freaklabs/BoomBox/hw/sch/Boombox-Mem/Boombox-Mem v0.5.pdf

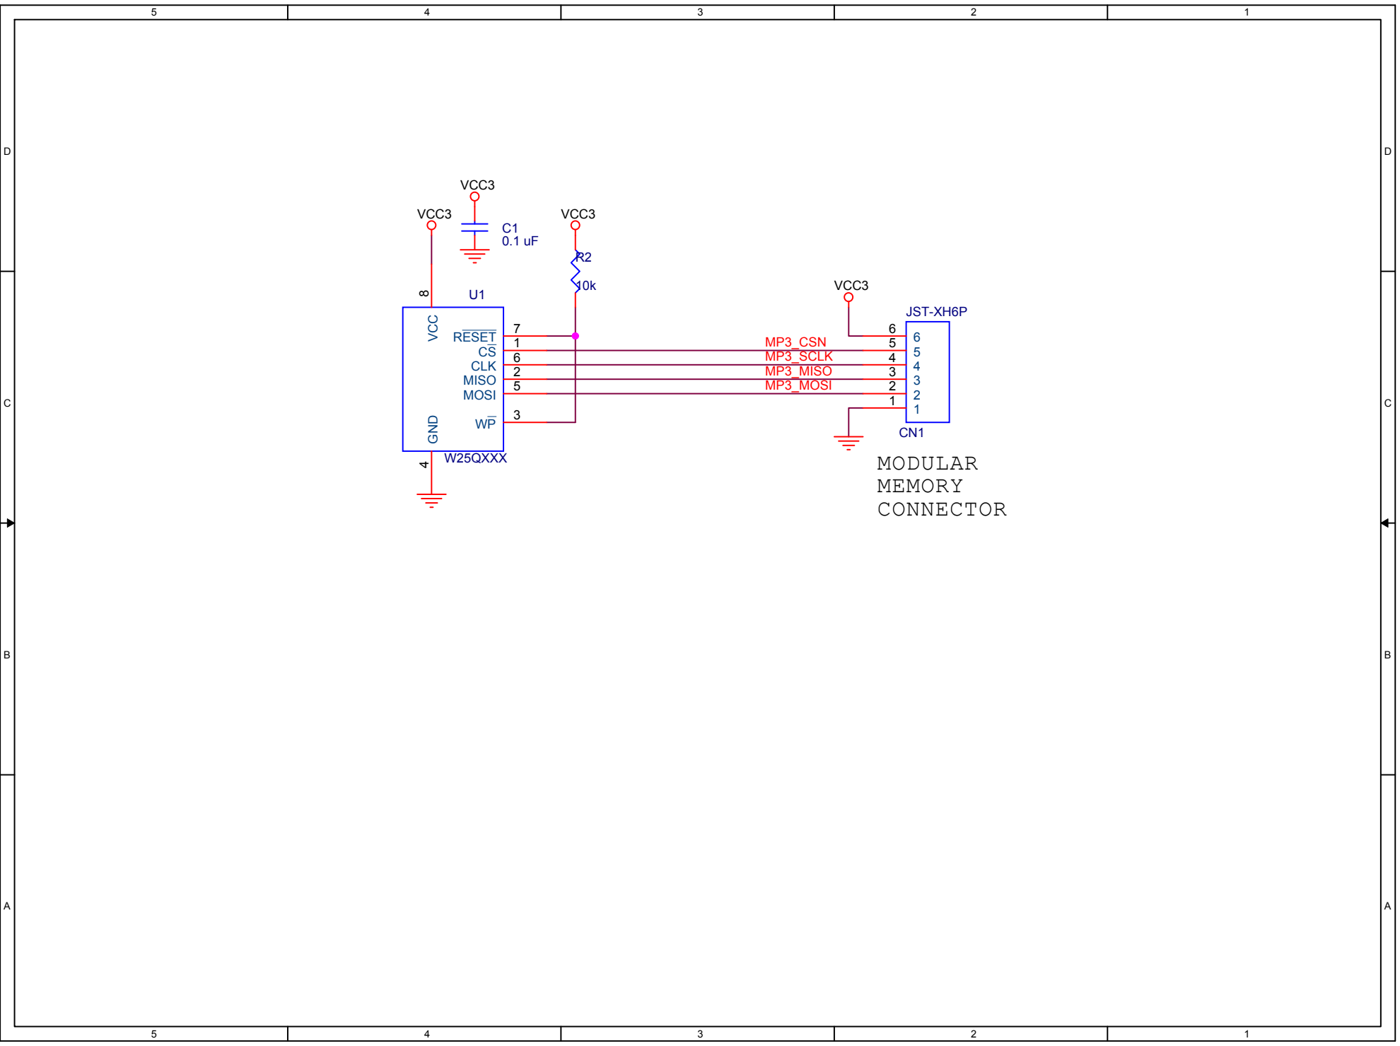
[picture p1: figure]
MODULAR MEMORY CONNECTOR; MP3_CSN MP3_SCLK MP3_MISO MP3_MOSI; VCC3; W25QXXX; MISO; GND; MOSI; CLK; RESET; 7 VCC; JST-XH6P
