freaklabs/BoomBox/hw/sch/Boombox/FL-BOOMBOX.xlsx

Item | Quantity | Reference | Part
1 | 4 | BATT1,CN2,CN3,CN7 | JST-XH2P
2 | 2 | CN1,CN8 | JST-XH6P
3 | 3 | CN4,CN5,CN6 | JST-XH3P
4 | 11 | C1,C4,C9,C10,C13,C14,C15, | 0.1 uF
 |  | C16,C19,C23,C26
5 | 5 | C2,C3,C24,C27,C28 | 100uF/16V
6 | 2 | C5,C6 | 1 uF
7 | 2 | C7,C8 | 0.47 uF
8 | 2 | C11,C12 | 470 uF/6.3V
9 | 2 | C17,C20 | 12pF
10 | 1 | C18 | 22uF/6.3V
11 | 1 | C21 | DNI
12 | 2 | C22,C25 | 22uF, 6.3V
13 | 3 | D1,D2,D3 | RED
14 | 1 | D4 | SCHOTTKY_DIODE
15 | 3 | D5,D6,D7 | DO-35
16 | 4 | H1,H2,H4,H5 | MOUNT_HOLE/MOUNT_HOLE
17 | 1 | H3 | H3X2
18 | 1 | J1 | USB-Mini-AB
19 | 1 | J2 | POWERJACK_STRAIGHT
20 | 2 | L1,L2 | 47 uH
21 | 3 | Q1,Q2,Q3 | APM9926
22 | 1 | R1 | 1k
23 | 13 | R2,R3,R4,R5,R6,R8,R9,R10, | 10k
 |  | R11,R13,R17,R18,R20
24 | 3 | R7,R12,R14 | 220
25 | 2 | R15,R16 | 3k
26 | 1 | R19 | 30k
27 | 1 | SW1 | DIPSWITCH4/DIP
28 | 2 | S1,S3 | PUSHBUTTON/SMD
29 | 1 | S2 | SWITCH_SLIDE/THRU-3
30 | 10 | TP1,TP2,TP3,TP4,TP5,TP6, | TP
 |  | TP7,TP8,TP9,TP10
31 | 1 | U1 | W25QXXX
32 | 1 | U2 | YX6100-16S
33 | 1 | U3 | PAM8403
34 | 1 | U4 | 2.5V
35 | 1 | U5 | ATMEGA328-QFP32
36 | 1 | U6 | AP2112K-3.3TRG1
37 | 1 | U7 | AMS2954C
38 | 1 | U8 | AZ1117
39 | 1 | U9 | CE8301A50
40 | 1 | U10 | XL6009
41 | 1 | VR1 | RV097NS
42 | 1 | Y1 | 7.3728 MHz
