freaklabs/BoomBox/hw/sch/Boombox/fl-boombox-v0.6.pdf

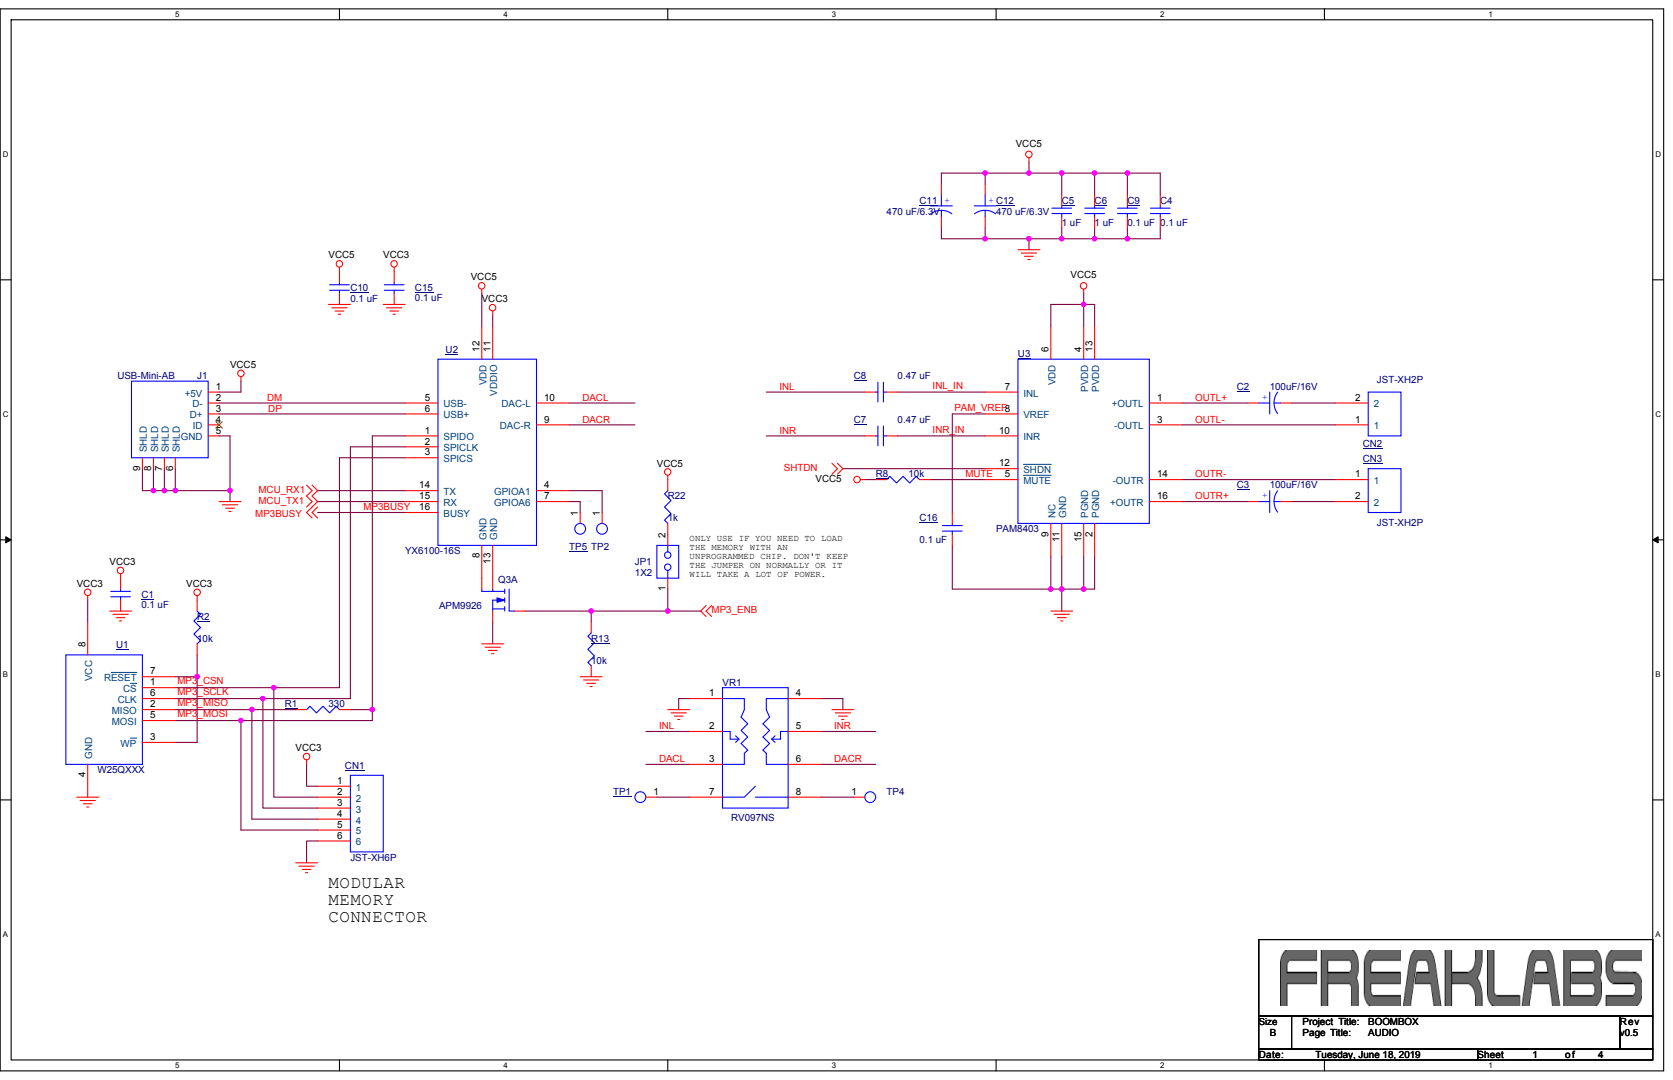
[picture p2: page 1]

SPICS 3

TX 14 RX 15 BUSY 16

ONLY USE IF YOU NEED TO LOAD
THE MEMORY WITH AN
UNPROGRAMMED CHIP. DON'T KEEP
THE JUMPER ON NORMALLY OR IT
WILL TAKE A LOT OF POWER.

Size Size Size B B B | Project Title: Project Title: Project Title: BOOMBOX BOOMBOX BOOMBOX Page Title: Page Title: Page Title: AUDIO AUDIO AUDIO | Rev Rev Rev v0.5 v0.5 v0.5

Date: Tuesday, June 18, 2019 Tuesday, June 18, 2019 Tuesday, June 18, 2019 | Sheet 1 1 1 of 4 4 4

# PIR MOTION SENSOR

## PIR_ENB

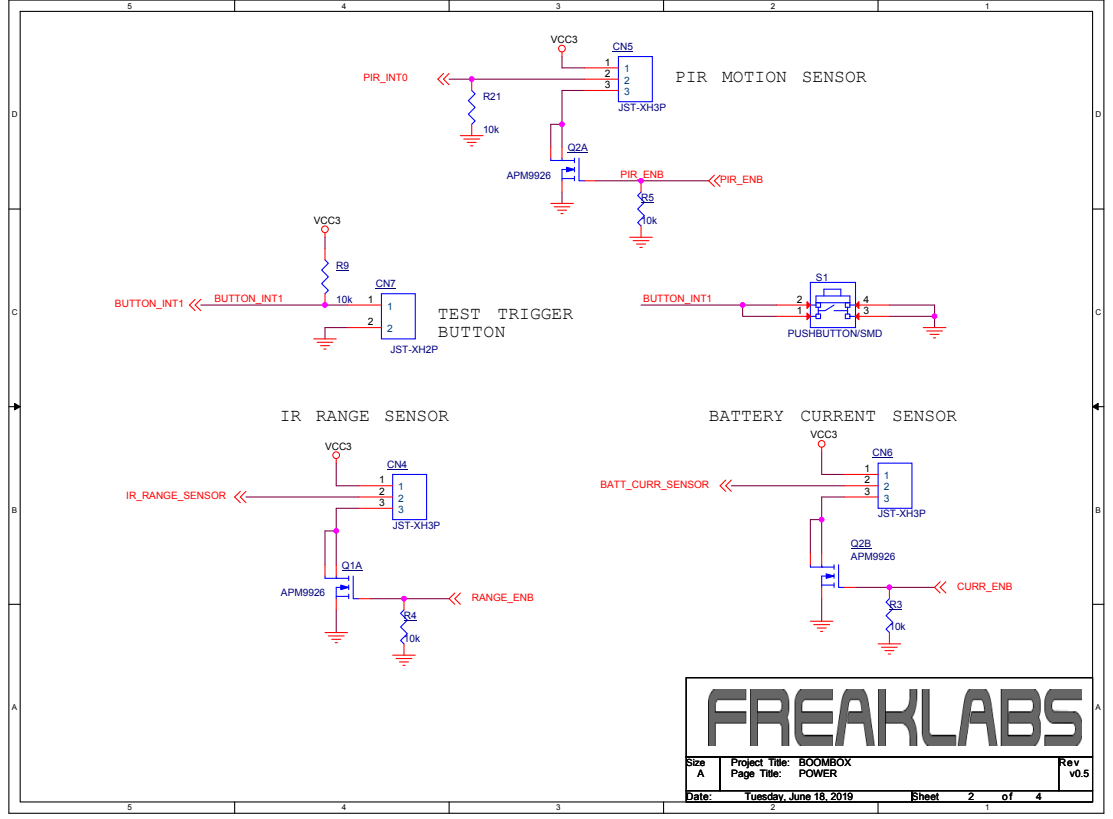
[picture p3: page 2]

Size Size Size A A A | Project Title: Project Title: Project Title: BOOMBOX BOOMBOX BOOMBOX Page Title: Page Title: Page Title: POWER POWER POWER | Rev Rev Rev v0.5 v0.5 v0.5

Tuesday, June 18, 2019 Tuesday, June 18, 2019 Tuesday, June 18, 2019 | 2 2 2 4 4 4

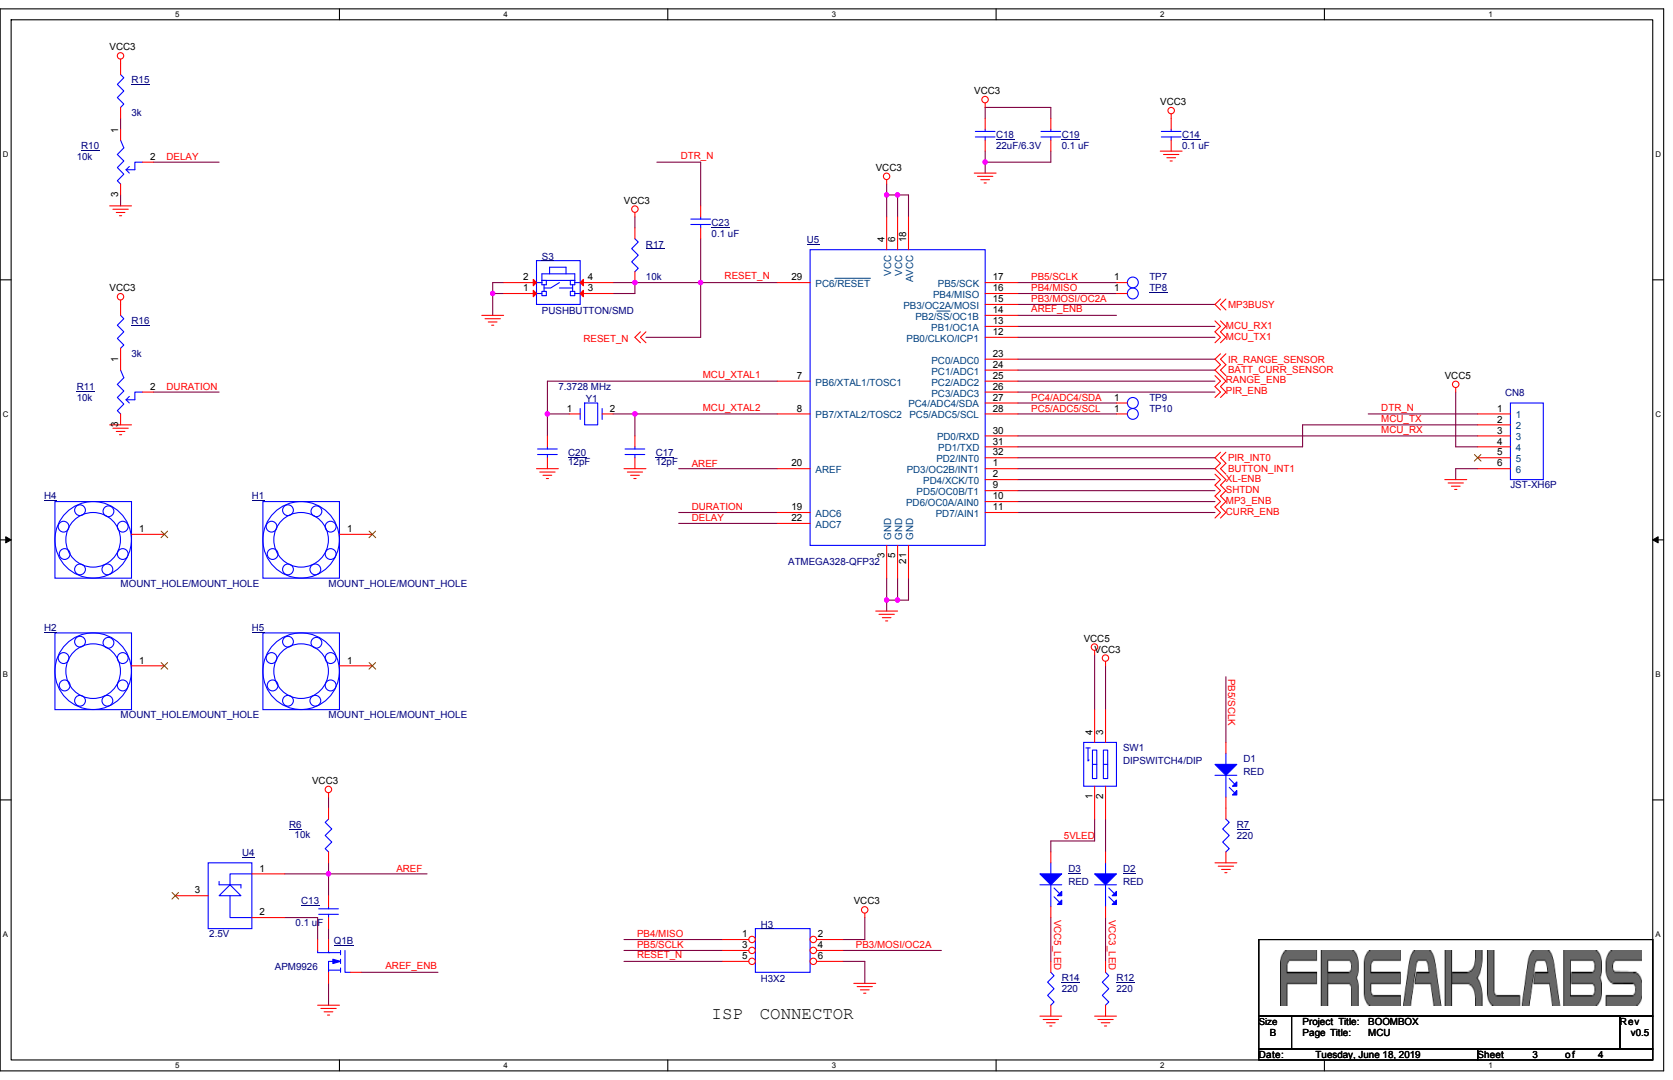
[picture p4: page 3]

MCU_RX | 3 3

Size Size Size B B B | Project Title: Project Title: Project Title: BOOMBOX BOOMBOX BOOMBOX Page Title: Page Title: Page Title: MCU MCU MCU | Rev Rev Rev v0.5 v0.5 v0.5

Tuesday, June 18, 2019 Tuesday, June 18, 2019 Tuesday, June 18, 2019 | 3 3 3 4 4 4

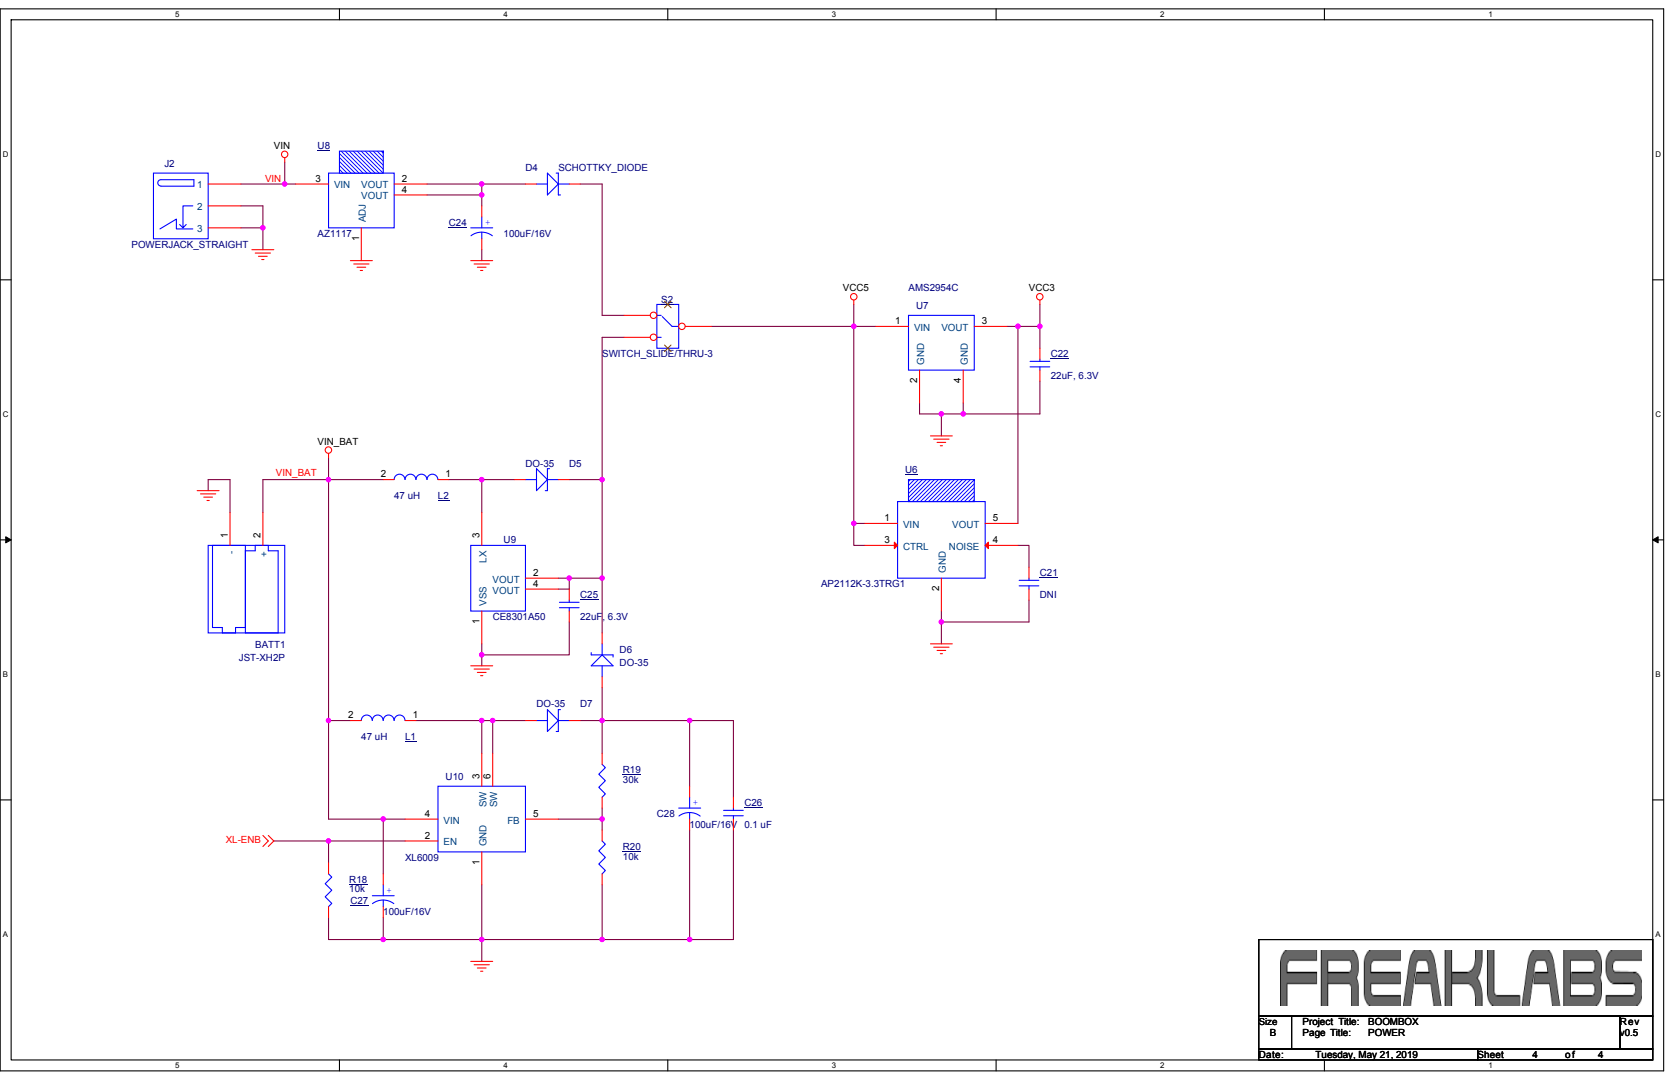
[picture p5: page 4]
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

Tuesday, May 21, 2019 Tuesday, May 21, 2019 Tuesday, May 21, 2019 | 4 4 4
