freaklabs/BoomBox/hw/sch/Boombox/fl-boombox-v0.5.pdf

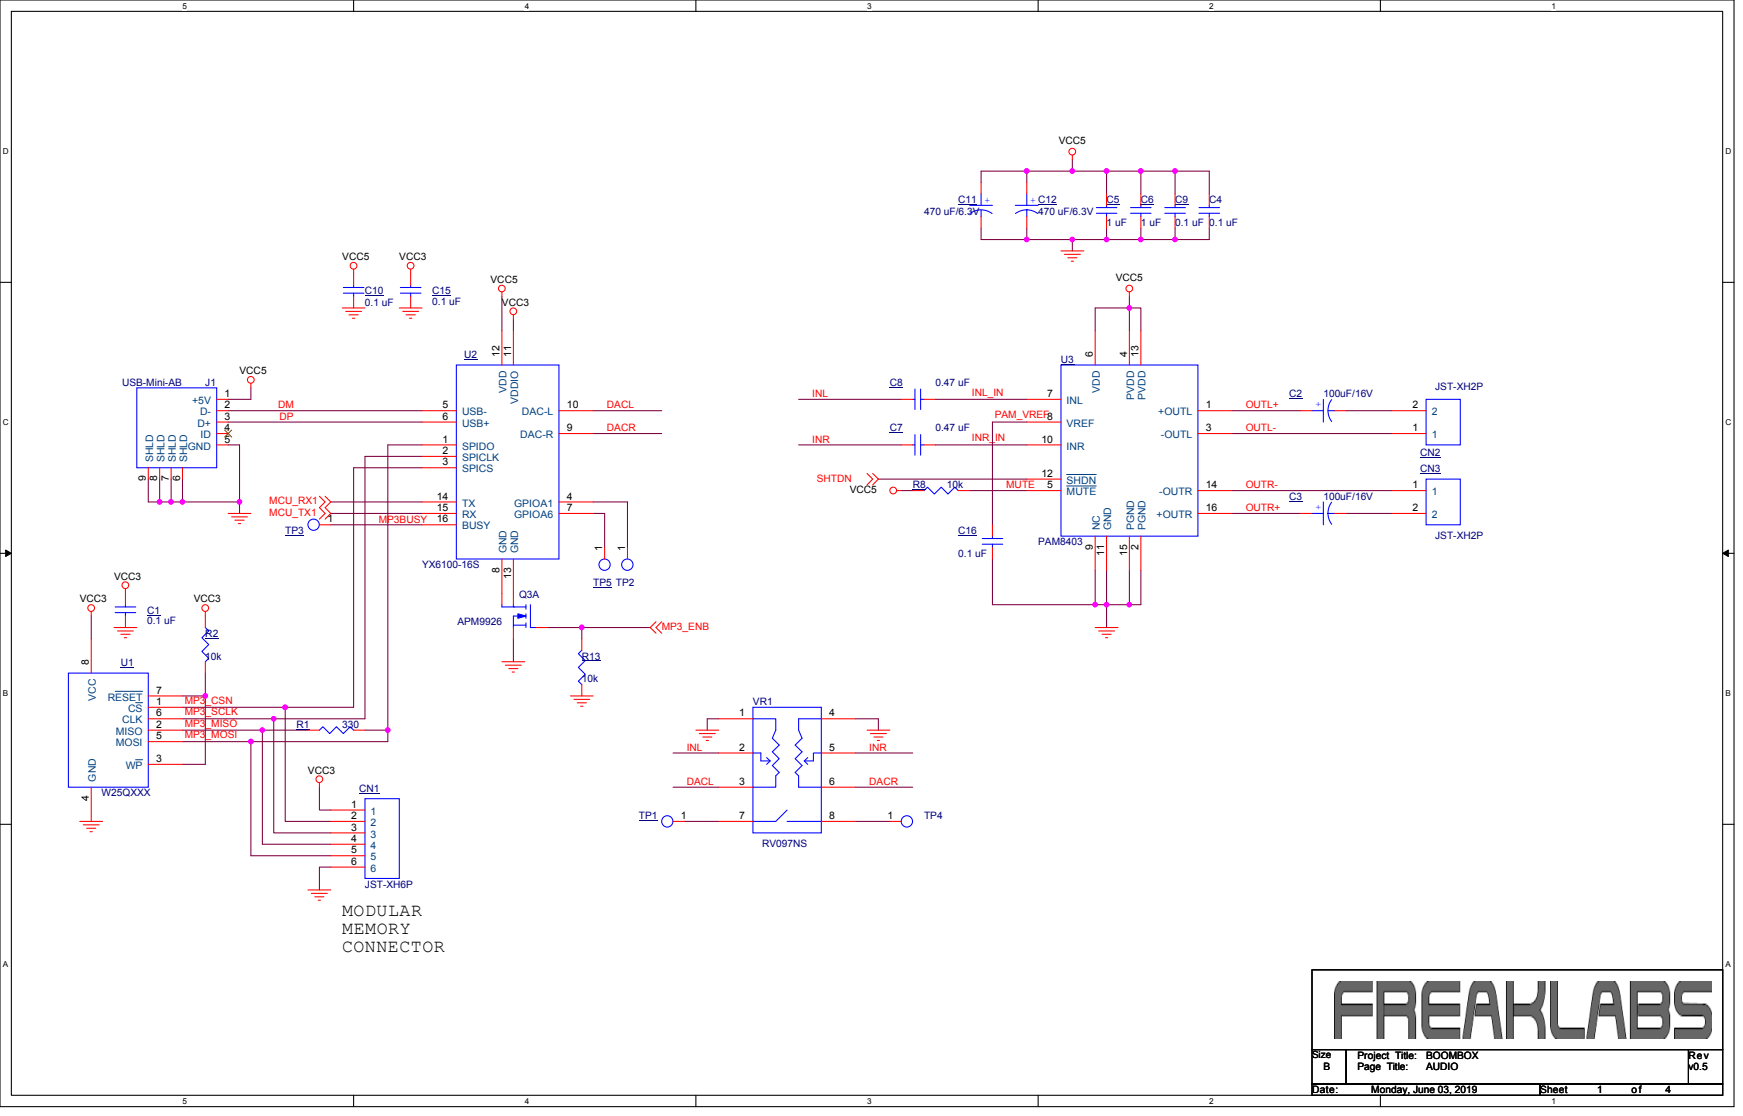
[picture p6: page 1]

SPICS 3

TX 14 RX 15 BUSY 16

Size Size Size B B B | Project Title: Project Title: Project Title: BOOMBOX BOOMBOX BOOMBOX Page Title: Page Title: Page Title: AUDIO AUDIO AUDIO | Rev Rev Rev v0.5 v0.5 v0.5

Date: Date: Date: Monday, June 03, 2019 Monday, June 03, 2019 Monday, June 03, 2019 | Sheet Sheet Sheet 1 1 1 of of of 4 4 4

D | D

# PIR MOTION SENSOR

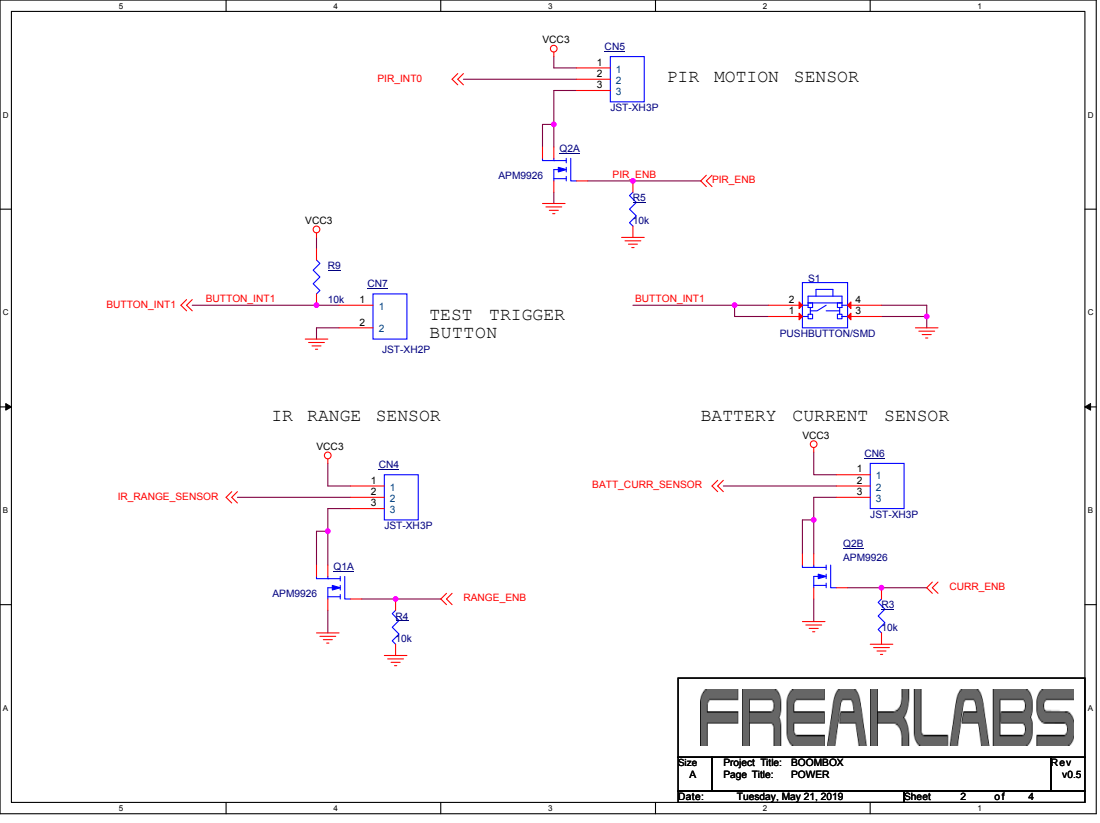
[picture p7: page 2]

Size Size Size A A A | Project Title: Project Title: Project Title: BOOMBOX BOOMBOX BOOMBOX Page Title: Page Title: Page Title: POWER POWER POWER | Rev Rev Rev v0.5 v0.5 v0.5

Date: Date: Date: Tuesday, May 21, 2019 Tuesday, May 21, 2019 Tuesday, May 21, 2019 | Sheet Sheet Sheet 2 2 2 of of of 4 4 4

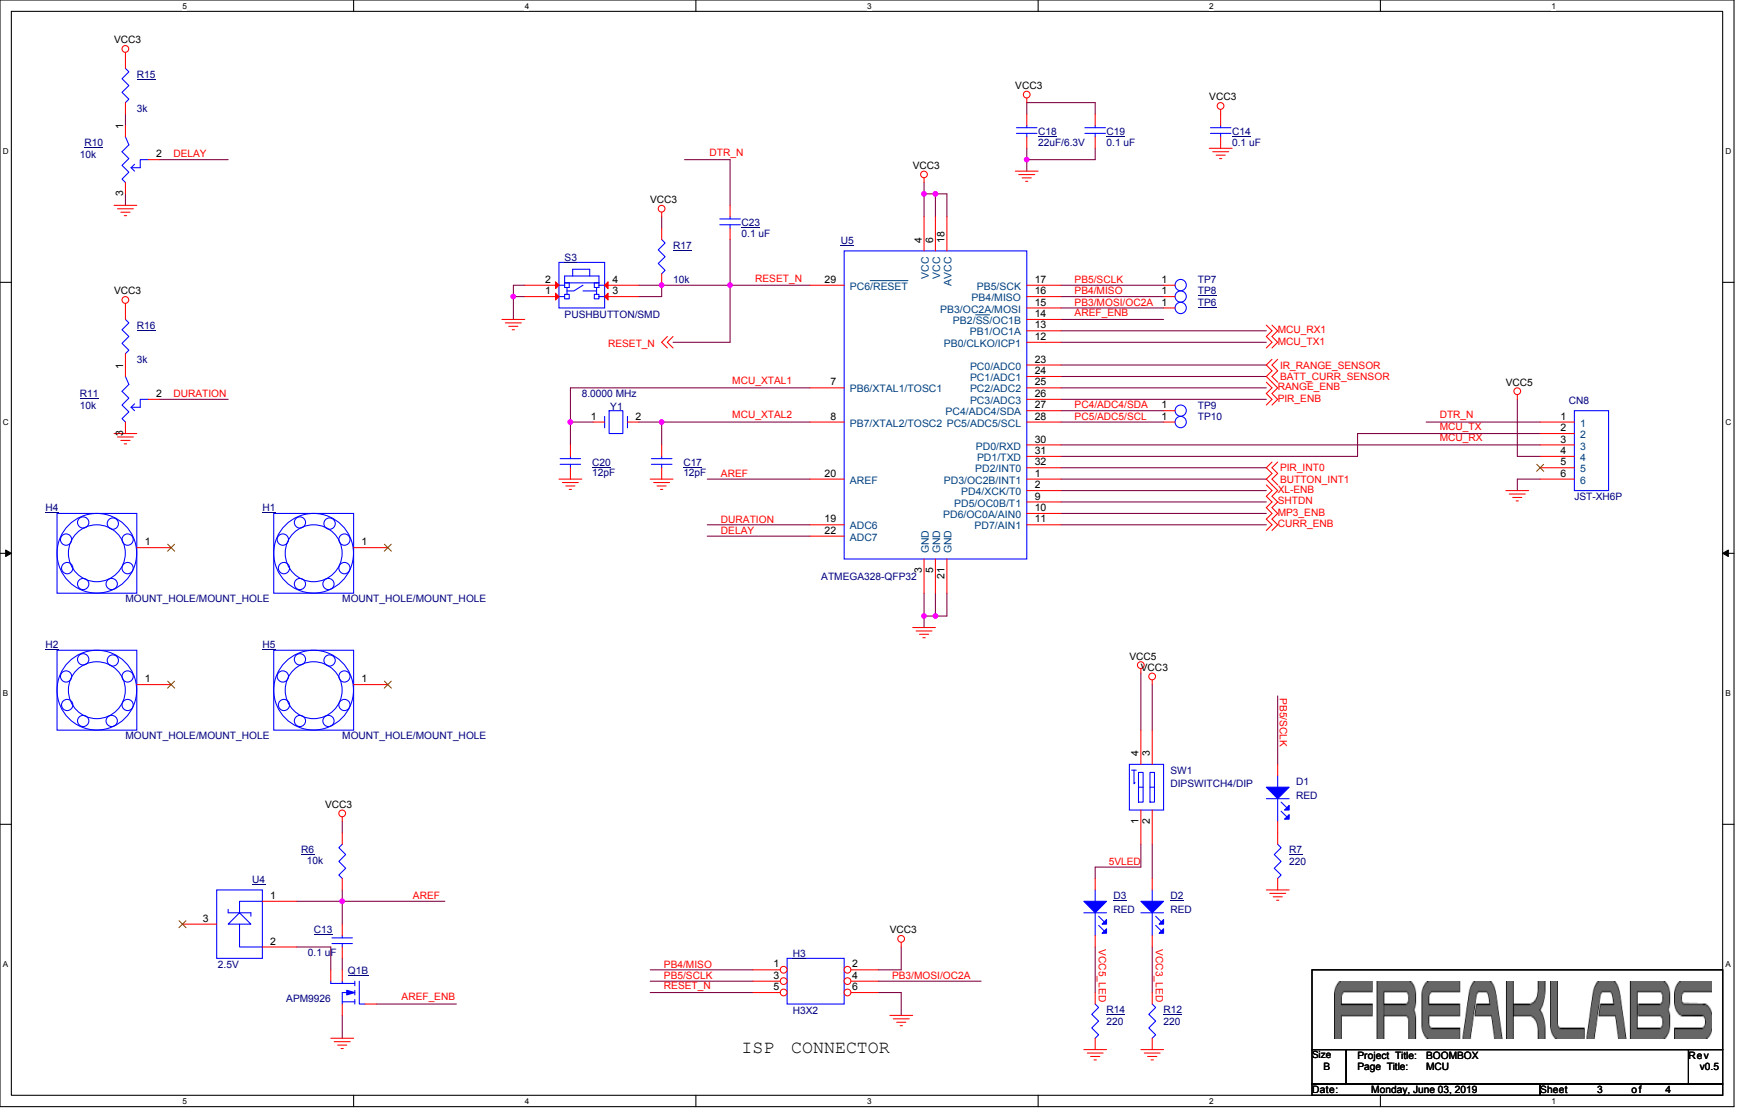
[picture p8: page 3]

Size Size Size B B B | Project Title: Project Title: Project Title: BOOMBOX BOOMBOX BOOMBOX Page Title: Page Title: Page Title: MCU MCU MCU | Rev Rev Rev v0.5 v0.5 v0.5

Date: Date: Date: Monday, June 03, 2019 Monday, June 03, 2019 Monday, June 03, 2019 | Sheet Sheet Sheet 3 3 3 of of of 4 4 4

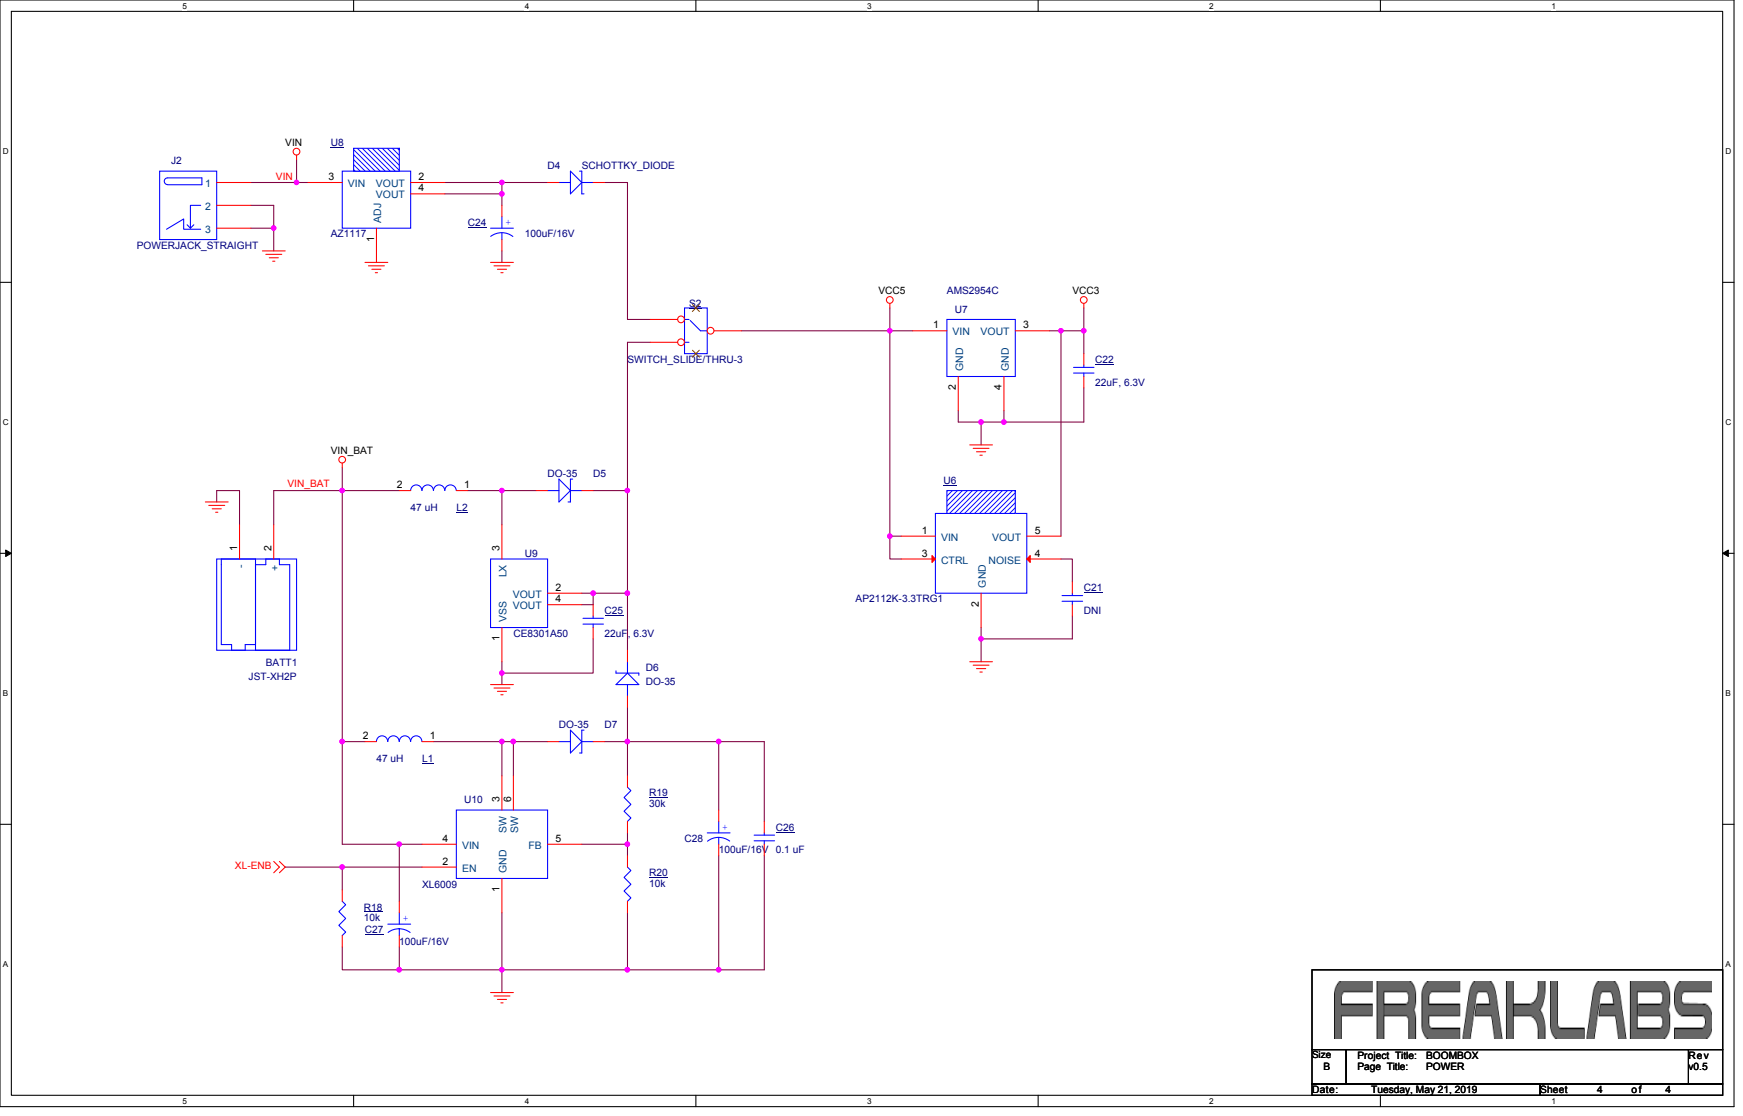
[picture p9: page 4]
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

Date: Date: Date: Tuesday, May 21, 2019 Tuesday, May 21, 2019 Tuesday, May 21, 2019 | Sheet Sheet Sheet 4 4 4 of of of 4 4 4
