freaklabs/BoomBox/(list of files, drawings)

Other design files:
hw/pcb/Boombox-Mem/FL- BOOMBOX-MEM-V0.5.pcb
hw/sch/Boombox-Mem/FL- BOOMBOX-MEM.DSN
hw/sch/Boombox-Mem/FL- BOOMBOX-MEM.opj
hw/sch/Boombox/FL-BOOMBOX.DSN
hw/sch/Boombox/fl-boombox.opj
hw/sch/FL-BOOMBOX.opj
