freaklabs/BoomBox/sw/sketches/boombox/standard/deployment/commands.ino

/**************************************************************************/
// Init command table
/**************************************************************************/
void cmdTableInit()
{
    cmd.add("play", cmdPlay);
    cmd.add("stop", cmdStop);
    cmd.add("settime", cmdSetDateTime);
    cmd.add("gettime", cmdGetDateTime);     
    cmd.add("setname", cmdSetName);
    cmd.add("setid", cmdSetId);
    cmd.add("setmode", cmdSetMode);
    cmd.add("setmaxsounds", cmdSetMaxSounds);
    cmd.add("setshuffle", cmdSetShuffle);
    cmd.add("setdelay", cmdSetDelay);
    cmd.add("setoffdelay", cmdSetOffDelay);
    cmd.add("config", cmdDumpConfig);
    cmd.add("normal", cmdSetNormal);
    cmd.add("help", cmdHelp);
}

/************************************************************/

/************************************************************/
void cmdHelp(int argCnt, char **args)
{
    (void) argCnt;
    (void) args;
        
    Serial.println(F("play          - Play sound. Usage: 'play <sound number>'"));        
    Serial.println(F("stop          - Stop a sound from playing. Usage: 'stop'")); 
    Serial.println(F("vol           - Set volume. Usage: 'vol <num from 1-30>'"));
    Serial.println(F("setname       - Set name. Usage: 'setname <name>'"));
    Serial.println(F("setid         - Set boombox ID. Usage: 'setid <num from 0-255>'"));
    Serial.println(F("setmode       - Set test mode. Usage: 'setmode <0=standalone, 1=camera trap>'"));
    Serial.println(F("setmaxsounds  - Set max number of sounds. Usage: 'setmaxsounds <num>'"));
    Serial.println(F("setshuffle    - Set shuffle mode. Usage: 'setshuffle <0=sequential, 1=shuffle>'"));
    Serial.println(F("setinterval   - Set interval. Currently unused."));
    Serial.println(F("setdelay      - Set delay. This is delay from trigger to playback. Usage: 'setdelay <delay in seconds>'"));
    Serial.println(F("setoffdelay   - Set offdelay. This is blackout period after playback & before next trigger is allowed. Usage: 'setoffdelay <delay in seconds>'"));    
    Serial.println(F("config        - Display metadata configuration data. Usage: 'config'"));
    Serial.println(F("normal        - Go into normal (deployment) mode and exit command line mode. Usage: 'normal'"));
}

/********************************************************************/
// cmdSetNormal
/********************************************************************/
void cmdSetNormal(int argCnt, char **args)
{
    (void) argCnt;
    (void) args;
    
    normalMode = true;   
    Serial.println("Going into normal operation mode.");
    Serial.flush();     
}

/**************************************************************************/
// setDateTime
/**************************************************************************/
void cmdSetDateTime(int argCnt, char **args)
{
#if (BOOMBOX == 1)    
    (void) argCnt;
    (void) args;
        
    uint8_t day, mon, year, hr, min, sec;

    year = strtol(args[1], NULL, 10);
    mon = strtol(args[2], NULL, 10);
    day = strtol(args[3], NULL, 10);
    hr = strtol(args[4], NULL, 10);
    min = strtol(args[5], NULL, 10);
    sec = strtol(args[6], NULL, 10);

    rtc.setDateTime(day, 0, mon, 0, year, hr, min, sec);      
    printf("Now = %s.\n", rtcPrintTimeAndDate());
#endif    
}

/**************************************************************************/
// getDateTime
/**************************************************************************/
void cmdGetDateTime(int argCnt, char **args)
{
#if (BOOMBOX == 1)    
    (void) argCnt;
    (void) args;
        
    printf("Now = %s.\n", rtcPrintTimeAndDate());
#endif    
}

/************************************************************/
//
/************************************************************/
void cmdSetName(int argCnt, char **args)
{
  char buf[MAX_FIELD_SIZE];

  EEPROM.get(EEPROM_META_LOC, meta);
  memset(meta.devName, 0, sizeof(meta.devName));
  strCat(buf, 1, argCnt, args);
  strncpy(meta.devName, buf, MAX_FIELD_SIZE - 1);
  EEPROM.put(EEPROM_META_LOC, meta);
}

/************************************************************/
//
/************************************************************/
void cmdSetDelay(int argCnt, char **args)
{
  if (argCnt != 2)
  {
    Serial.println("Incorrect number of arguments.");
    return;
  }

  uint16_t delayTime = cmd.conv(args[1]);
  EEPROM.get(EEPROM_META_LOC, meta);
  meta.delayTime = delayTime;
  EEPROM.put(EEPROM_META_LOC, meta);
}

/************************************************************/
//
/************************************************************/
void cmdSetOffDelay(int argCnt, char **args)
{
  if (argCnt != 2)
  {
    Serial.println("Incorrect number of arguments.");
    return;
  }

  uint16_t offDelay = cmd.conv(args[1]);
  EEPROM.get(EEPROM_META_LOC, meta);
  meta.offDelayTime = offDelay;
  EEPROM.put(EEPROM_META_LOC, meta);
}
/************************************************************/
//
/************************************************************/
void cmdSetId(int argCnt, char **args)
{
  if (argCnt != 2)
  {
    Serial.println("Incorrect number of arguments.");
    return;
  }

  uint8_t id = cmd.conv(args[1]);
  EEPROM.get(EEPROM_META_LOC, meta);
  meta.devID = id;
  EEPROM.put(EEPROM_META_LOC, meta);
}

/************************************************************/
//
/************************************************************/
void cmdSetMode(int argCnt, char **args)
{
  if (argCnt != 2)
  {
    Serial.println("Incorrect number of arguments.");
    return;
  }

  uint8_t mode = cmd.conv(args[1]);

  if (mode > 1)
  {
    printf("ERROR: Invalid value. Setting to 0.\n");
    printf("Usage: 0 = STANDALONE mode, 1 = TRAILCAM mode\n");
  }
  
  EEPROM.get(EEPROM_META_LOC, meta);
  meta.devMode = mode;
  EEPROM.put(EEPROM_META_LOC, meta);
}

/************************************************************/
//
/************************************************************/
void cmdSetMaxSounds(int argCnt, char **args)
{
  if (argCnt != 2)
  {
    Serial.println("Incorrect number of arguments.");
    return;
  }

  uint16_t maxSounds = cmd.conv(args[1]);
  EEPROM.get(EEPROM_META_LOC, meta);
  meta.maxSounds = maxSounds;
  EEPROM.put(EEPROM_META_LOC, meta);
  boombox.setMaxSounds(meta.maxSounds);
}

/************************************************************/
//
/************************************************************/
void cmdSetShuffle(int argCnt, char **args)
{
  if (argCnt != 2)
  {
    Serial.println("Incorrect number of arguments.");
    return;
  }

  bool shuffleEnb = cmd.conv(args[1]);
  EEPROM.get(EEPROM_META_LOC, meta);
  meta.shuffleEnable = shuffleEnb;
  EEPROM.put(EEPROM_META_LOC, meta);

  if (meta.shuffleEnable == 0)
  {
    boombox.setShuffle(0);
  }
  else
  {
    boombox.setShuffle(1);
  }
  boombox.initPlaylist(playlist, meta.maxSounds, meta.shuffleEnable);
}

/**************************************************************************/
// cmdSetSite
/**************************************************************************/
void cmdDumpConfig(int argCnt, char **args)
{
    (void) argCnt;
    (void) args;

    Serial.print(F("Device Name: \t")); Serial.println(meta.devName); 
    Serial.print(F("Device ID:   \t")); Serial.println(meta.devID);
    Serial.print(F("Shuffle:     \t")); Serial.println(meta.shuffleEnable); 
    Serial.print(F("Device Mode: \t")); Serial.println(meta.devMode ? "TRAILCAM" : "STANDALONE");
    Serial.print(F("Max Sounds:  \t")); Serial.println(meta.maxSounds);
    Serial.print(F("Delay Time:  \t")); Serial.println(meta.delayTime);
    Serial.print(F("Off Delay:   \t")); Serial.println(meta.offDelayTime);
    Serial.print(F("Interval:    \t")); Serial.println(meta.devInterval);
}

/************************************************************/
// Play track
// Usage: play <track number>
/************************************************************/
void cmdPlay(int argCnt, char **args)
{
    (void) argCnt;   
   
    uint8_t track = cmd.conv(args[1]);

    // enable amp
    boombox.ampEnable();       
    delay(AMP_ENABLE_DELAY); // this delay is short and just so the start of the sound doesn't get cut off as amp warms up
    digitalWrite(boombox.pinMute, HIGH); // unmute system
    
    boombox.playBusy(track);

    // disable amp before going to sleep. Short delay so sound won't get cut off too suddenly
    // with additional delay after to allow amp to shut down
    delay(500);
    digitalWrite(boombox.pinMute, LOW); // mute system  
    boombox.ampDisable();   
}

/************************************************************/
// Set volume
// Usage: vol <volume level>
// volume level is between 0 and 30
/************************************************************/
void cmdSetVolume(int argCnt, char **args)
{
    (void) argCnt;
    
    uint8_t vol = cmd.conv(args[1]);
    if (vol > 30)
    {
        vol = 30;
    }
    boombox.setVol(vol);
}

/************************************************************/
// Stop playing
/************************************************************/
void cmdStop(int argCnt, char **args)
{
    (void) argCnt;
    (void) args;
        
    boombox.stop();
}
