freaklabs/BoomBox/sw/sketches/boombox/disco/testOnly-disco/helpers.ino

/**************************************************************************/
// Fill strip pixels one after another with a color. Strip is NOT cleared
// first; anything there will be covered pixel by pixel. Pass in color
// (as a single 'packed' 32-bit value, which you can get by calling
// strip.Color(red, green, blue) as shown in the loop() function above),
// and a delay time (in milliseconds) between pixels.
/**************************************************************************/
void colorWipe0(uint32_t color, int wait) {
  for(uint16_t i=0; i<strip0.numPixels(); i++) { // For each pixel in strip...
    strip0.setPixelColor(i, color);         //  Set pixel's color (in RAM)
    strip0.show();                          //  Update strip to match
    delay(wait);                           //  Pause for a moment
  }
}

/**************************************************************************/
// Fill strip pixels one after another with a color. Strip is NOT cleared
// first; anything there will be covered pixel by pixel. Pass in color
// (as a single 'packed' 32-bit value, which you can get by calling
// strip.Color(red, green, blue) as shown in the loop() function above),
// and a delay time (in milliseconds) between pixels.
/**************************************************************************/
void colorWipe1(uint32_t color, int wait) {
  for(uint16_t i=0; i<strip1.numPixels(); i++) { // For each pixel in strip...
    strip1.setPixelColor(i, color);         //  Set pixel's color (in RAM)
    strip1.show();                          //  Update strip to match
    delay(wait);                           //  Pause for a moment
  }
}

/**************************************************************************/
/*!
    Concatenate multiple strings from the command line starting from the
    given index into one long string separated by spaces.
*/
/**************************************************************************/
int strCat(char *buf, unsigned char index, char argCnt, char **args)
{
    uint8_t i, len;
    char *data_ptr;

    data_ptr = buf;
    for (i=0; i<argCnt - index; i++)
    {
        len = strlen(args[i+index]);
        strcpy((char *)data_ptr, (char *)args[i+index]);
        data_ptr += len;
        *data_ptr++ = ' ';
    }
    // remove the trailing space
    data_ptr--;
    *data_ptr++ = '\0';

    return data_ptr - buf;
}

/**************************************************************************/
// This is to implement the printf function from within arduino
/**************************************************************************/
int uart_putchar (char c, FILE *stream)
{
    (void) stream;
    Serial.write(c);
    return 0;
}
