freaklabs/BoomBox/(commit log)

2019-07-22 - Added Boombox schematic and PCB v0.6 - Added examples for boombox - Modified boombox library files
    [FL- BOOMBOX-MEM-V0.5.pcb, FL- BOOMBOX-MEM.DSN, FL- BOOMBOX-MEM.opj, FL-BOOMBOX.DSN, FL-BOOMBOX.xlsx, fl-boombox.opj]
2019-07-31 - Added sleep mode - Added watchdog timer funcitonality - Fixed bug in sketch to disable watchdog timer before going to sleep - added delay in wake
2019-08-01 - Modified sketch to have delay to fully play out mp3 sample
2019-08-04 Fixed button debounce issue on hardware Uploaded working boomboxMain file
2019-08-08 Added PIR deployment code Modified sleep code to keep PIR powered on during sleep
2021-07-10 Made modifications based on current setup
2021-07-10 Added drivers for USB serial
2021-07-20 Adding Low Power library Changed name to deploymentBoomboxMain Removed PIR sketch
2021-07-21 Added workaround for floating shutdown issue Implemented randomized shuffle playlist function in sketches
    [deploymentBoomboxMain.ino, testBoomboxTrailcam.ino]
2022-03-10 Removed hardware directory. Please update board hardware via boards manager Fixed bug where software serial had an ISR conflict with chibiArduino Added separate amp enable and disable functions Addd 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
    [commands.ino, deploymentBoomboxMain.ino, helpers.ino, testBoomboxTrailcam.ino]
2022-03-22 Changed folder name to non-Camera Trap
2022-05-28 Added boombox wireless initial code
2022-10-18 Changed testboomboxstandalone sketches to be falling interrupt
2022-11-28 - Added support for new boombox boards - Added differentiation between original board, now called BoomboxBase and new board, called Boombox - Added support for both boards in library
2022-11-29 Cleaned up repo Added support for new boombox 2023 boards
2022-11-29 Fixed issue where when you change maxSounds, it will now update the system
    [commands.ino]
2022-11-29 Fixed bug on setMaxSounds
    [commands.ino]
2022-11-30 Removed print statements in RTC library
2022-12-13 Updated commands to fix error in help menu
    [commands.ino]
2023-05-23 Fixed bug in time based playlist Fixed bugs in deployment code
    [commands.ino, deployment.ino]
2023-06-11 Updated boombox disco deployment and testonly code to fix memory issues
    [commands.ino, deployment-disco.ino, testOnly-disco.ino]
2023-06-14 Fixed reset bug in disco sketches
    [deployment-disco.ino, testOnly-disco.ino]
2023-06-20 Added power sequencing to sleep and wake to avoid large power spike when turning on 5V supply
    [commands.ino]
2023-06-21 Added power sequencing to startup sequence also
2023-10-26 Added mute pin support for amplifier Added new playlist management features
2024-01-16 Updated other boombox code to be compatible with current library version
2024-03-06 Adding updates for latest Boombox board Adding anti-pop measures to remove pop when amplifier engages
2024-06-01 Added dual playlist support for normal camera trap operation in libraries/boombox/examples/deployment-dual-playlist Updated all sketches in examples and experimental to be compatible with current boa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
2024-08-16 Updated USB serial driver CH340G from 3.4 to 3.8 USB Serial driver is now compatible with Windows 11 Updated timelock debounce code to fix logic bugs in timelock function
2025-04-22 Fixed typo in setmode help listing
    [commands.ino, deployment.ino]
